dokaniasourav/GREEN_BUILDING/PERSON_COUNTER/readTemprature.ino

void readTemprature()
{
//  int temp=0;
//  for(byte i=0; i<5; i++)
//  {
//    temp = temp + analogRead(TEMPRATURE_PIN)/2;
//    delay(1);
//  }
//  current_temp = (byte)(temp/5);
//  Serial.print("Temperature Value = ");
//  Serial.println(current_temp);
    current_temp = 25;
}
