dokaniasourav/GREEN_BUILDING/UI-New/readTemperature.ino

void readTemperature()
{
//  int temp=0;
//  for(byte i=0; i<5; i++)
//  {
//    temp = temp + analogRead(TEMPERATURE_PIN)/2;
//    delay(1);
//  }
//  current_temp = (byte)(temp/5);
//  temperature = ((temperature*2) + current_temp)/3;
current_temp = 25;
}
